sarveshjoshi29/processor_hardwarelab/nexys_a7.xdc

## ============================================================================
## Nexys A7-100T XDC Constraints for RV32IMA Dual-Core SoC
## ============================================================================
## Board: Digilent Nexys A7-100T (Artix-7 XC7A100T-1CSG324C)
## ============================================================================

## ---- Clock (100 MHz onboard oscillator) ----
set_property -dict { PACKAGE_PIN E3  IOSTANDARD LVCMOS33 } [get_ports {CLK100MHZ}]
create_clock -add -name sys_clk_pin -period 10.00 -waveform {0 5} [get_ports {CLK100MHZ}]

## ---- Reset (Center Button — BTNC) ----
set_property -dict { PACKAGE_PIN N17 IOSTANDARD LVCMOS33 } [get_ports {BTNC}]

## ---- Slide Switches (active-high) ----
set_property -dict { PACKAGE_PIN J15 IOSTANDARD LVCMOS33 } [get_ports {SW[0]}]
set_property -dict { PACKAGE_PIN L16 IOSTANDARD LVCMOS33 } [get_ports {SW[1]}]
set_property -dict { PACKAGE_PIN M13 IOSTANDARD LVCMOS33 } [get_ports {SW[2]}]
set_property -dict { PACKAGE_PIN R15 IOSTANDARD LVCMOS33 } [get_ports {SW[3]}]
set_property -dict { PACKAGE_PIN R17 IOSTANDARD LVCMOS33 } [get_ports {SW[4]}]
set_property -dict { PACKAGE_PIN T18 IOSTANDARD LVCMOS33 } [get_ports {SW[5]}]
set_property -dict { PACKAGE_PIN U18 IOSTANDARD LVCMOS33 } [get_ports {SW[6]}]
set_property -dict { PACKAGE_PIN R13 IOSTANDARD LVCMOS33 } [get_ports {SW[7]}]
set_property -dict { PACKAGE_PIN T8  IOSTANDARD LVCMOS33 } [get_ports {SW[8]}]
set_property -dict { PACKAGE_PIN U8  IOSTANDARD LVCMOS33 } [get_ports {SW[9]}]
set_property -dict { PACKAGE_PIN R16 IOSTANDARD LVCMOS33 } [get_ports {SW[10]}]
set_property -dict { PACKAGE_PIN T13 IOSTANDARD LVCMOS33 } [get_ports {SW[11]}]
set_property -dict { PACKAGE_PIN H6  IOSTANDARD LVCMOS33 } [get_ports {SW[12]}]
set_property -dict { PACKAGE_PIN U12 IOSTANDARD LVCMOS33 } [get_ports {SW[13]}]
set_property -dict { PACKAGE_PIN U11 IOSTANDARD LVCMOS33 } [get_ports {SW[14]}]
set_property -dict { PACKAGE_PIN V10 IOSTANDARD LVCMOS33 } [get_ports {SW[15]}]

## ---- LEDs ----
set_property -dict { PACKAGE_PIN H17 IOSTANDARD LVCMOS33 } [get_ports {LED[0]}]
set_property -dict { PACKAGE_PIN K15 IOSTANDARD LVCMOS33 } [get_ports {LED[1]}]
set_property -dict { PACKAGE_PIN J13 IOSTANDARD LVCMOS33 } [get_ports {LED[2]}]
set_property -dict { PACKAGE_PIN N14 IOSTANDARD LVCMOS33 } [get_ports {LED[3]}]
set_property -dict { PACKAGE_PIN R18 IOSTANDARD LVCMOS33 } [get_ports {LED[4]}]
set_property -dict { PACKAGE_PIN V17 IOSTANDARD LVCMOS33 } [get_ports {LED[5]}]
set_property -dict { PACKAGE_PIN U17 IOSTANDARD LVCMOS33 } [get_ports {LED[6]}]
set_property -dict { PACKAGE_PIN U16 IOSTANDARD LVCMOS33 } [get_ports {LED[7]}]
set_property -dict { PACKAGE_PIN V16 IOSTANDARD LVCMOS33 } [get_ports {LED[8]}]
set_property -dict { PACKAGE_PIN T15 IOSTANDARD LVCMOS33 } [get_ports {LED[9]}]
set_property -dict { PACKAGE_PIN U14 IOSTANDARD LVCMOS33 } [get_ports {LED[10]}]
set_property -dict { PACKAGE_PIN T16 IOSTANDARD LVCMOS33 } [get_ports {LED[11]}]
set_property -dict { PACKAGE_PIN V15 IOSTANDARD LVCMOS33 } [get_ports {LED[12]}]
set_property -dict { PACKAGE_PIN V14 IOSTANDARD LVCMOS33 } [get_ports {LED[13]}]
set_property -dict { PACKAGE_PIN V12 IOSTANDARD LVCMOS33 } [get_ports {LED[14]}]
set_property -dict { PACKAGE_PIN V11 IOSTANDARD LVCMOS33 } [get_ports {LED[15]}]

## ---- 7-Segment Display ----
set_property -dict { PACKAGE_PIN T10 IOSTANDARD LVCMOS33 } [get_ports {SEG[0]}]
set_property -dict { PACKAGE_PIN R10 IOSTANDARD LVCMOS33 } [get_ports {SEG[1]}]
set_property -dict { PACKAGE_PIN K16 IOSTANDARD LVCMOS33 } [get_ports {SEG[2]}]
set_property -dict { PACKAGE_PIN K13 IOSTANDARD LVCMOS33 } [get_ports {SEG[3]}]
set_property -dict { PACKAGE_PIN P15 IOSTANDARD LVCMOS33 } [get_ports {SEG[4]}]
set_property -dict { PACKAGE_PIN T11 IOSTANDARD LVCMOS33 } [get_ports {SEG[5]}]
set_property -dict { PACKAGE_PIN L18 IOSTANDARD LVCMOS33 } [get_ports {SEG[6]}]

set_property -dict { PACKAGE_PIN J17 IOSTANDARD LVCMOS33 } [get_ports {AN[0]}]
set_property -dict { PACKAGE_PIN J18 IOSTANDARD LVCMOS33 } [get_ports {AN[1]}]
set_property -dict { PACKAGE_PIN T9  IOSTANDARD LVCMOS33 } [get_ports {AN[2]}]
set_property -dict { PACKAGE_PIN J14 IOSTANDARD LVCMOS33 } [get_ports {AN[3]}]
set_property -dict { PACKAGE_PIN P14 IOSTANDARD LVCMOS33 } [get_ports {AN[4]}]
set_property -dict { PACKAGE_PIN T14 IOSTANDARD LVCMOS33 } [get_ports {AN[5]}]
set_property -dict { PACKAGE_PIN K2  IOSTANDARD LVCMOS33 } [get_ports {AN[6]}]
set_property -dict { PACKAGE_PIN U13 IOSTANDARD LVCMOS33 } [get_ports {AN[7]}]

## ---- Decimal Point ----
set_property -dict { PACKAGE_PIN H15 IOSTANDARD LVCMOS33 } [get_ports {DP}]

## ---- UART on Nexys A7 onboard USB-UART (COM port) ----
## FPGA TX -> PC RX (Digilent name: UART_RXD_OUT)
set_property -dict { PACKAGE_PIN D4 IOSTANDARD LVCMOS33 } [get_ports {JA1}]
## PC TX -> FPGA RX (Digilent name: UART_TXD_IN)
set_property -dict { PACKAGE_PIN C4 IOSTANDARD LVCMOS33 } [get_ports {JA2}]

## ---- Timing Constraints ----
## The generated divided clock is not a true clock for Vivado;
## tell it to treat it as a generated clock for timing analysis.
## In full-speed mode (SW[15:14]=11), sys_clk = CLK100MHZ (no divider).
set_false_path -from [get_ports {BTNC}]
set_false_path -from [get_ports {SW[*]}]

## Constrain the divider output as a generated clock
## (full-speed mode: 50 MHz = divide-by-2; slower modes divide further)
create_generated_clock -name div_clk -source [get_ports CLK100MHZ] \
    -divide_by 2 [get_pins {div_clk_reg/Q}]

## Multi-cycle path for slow clock domains (debug modes)
## These are conservative — Vivado will over-constrain but still close timing.

## ---- Bitstream Configuration ----
set_property CFGBVS VCCO [current_design]
set_property CONFIG_VOLTAGE 3.3 [current_design]
set_property BITSTREAM.GENERAL.COMPRESS TRUE [current_design]
set_property BITSTREAM.CONFIG.CONFIGRATE 33 [current_design]
set_property CONFIG_MODE SPIx4 [current_design]
