sarveshjoshi29/processor_hardwarelab/modules/IF_ID.v

`timescale 1ns/1ps
// ============================================================================
// IF/ID Stage — Instruction Fetch & Decode
// ============================================================================
// Changes from Phase 1:
//   - Removed WB-stage forwarding signals (forwarding now handled centrally)
//   - Added flush input for branch mispredicts
//   - Pipeline register (id_ex_reg) now has flush support
//   - Added AUIPC immediate generation and signal passthrough
//   - Added RV32M (muldiv) decode
//   - Added branch prediction passthrough (predicted_taken, predicted_target)
// ============================================================================
module IF_ID
#(
    parameter [31:0] RESET = 32'h0000_0000
)
(
    input clk,
    input reset,         // active-low (negated externally)
    input stall,
    output reg exception,

    // Instruction memory interface
    input inst_mem_is_valid,
    input  [31:0] inst_mem_read_data,

    // Pipeline control
    input  stall_read_i,
    input  [31:0] inst_fetch_pc,
    input  [31:0] instruction_i,

    // Hazard control
    input  stall_if_id,      // 1 = hold IF/ID register (load-use stall)
    input  stall_div,        // 1 = divider busy, hold ID/EX register
    input  flush_if_id,      // 1 = insert NOP (branch flush)

    input  [1:0]  inst_mem_offset,

    // Outputs to ID/EX register
    output [31:0] execute_immediate_w,
    output        immediate_sel_w,
    output        alu_w,
    output        lui_w,
    output        auipc_w,
    output        jal_w,
    output        jalr_w,
    output        branch_w,
    output        mem_write_w,
    output        mem_to_reg_w,
    output        arithsubtype_w,
    output        muldiv_w,
    output [31:0] pc_w,
    output [4:0]  src1_select_w,
    output [4:0]  src2_select_w,
    output [4:0]  dest_reg_sel_w,
    output [2:0]  alu_operation_w,
    output        illegal_inst_w,
    output [31:0] instruction_o,

    // Branch prediction passthrough
    input         predicted_taken_i,
    input  [31:0] predicted_target_i,
    output        predicted_taken_w,
    output [31:0] predicted_target_w,

    // RV32A atomic passthrough
    output        atomic_lr_w,
    output        atomic_sc_w,

    // CSR passthrough (Phase 5)
    output        csr_en_w
);

`include "opcode.vh"

// ---- Local signals ----
reg  [31:0] immediate;
reg         illegal_inst;

// ============================================================================
// IF: Instruction selection
// ============================================================================
assign instruction_o = (inst_mem_read_data == 32'b0) ? NOP
                     : (stall_read_i)                ? NOP
                     : inst_mem_read_data;

// ============================================================================
// Exception detection
// ============================================================================
always @(posedge clk or negedge reset) begin
    if (!reset)
        exception <= 1'b0;
    else if (illegal_inst || inst_mem_offset != 2'b00)
        exception <= 1'b1;
    else
        exception <= exception;  // explicit hold — avoid latch inference
end

// ============================================================================
// ID: Immediate generation (combinational)
// ============================================================================
always @(*) begin
    immediate    = 32'h0;
    illegal_inst = 1'b0;

    case (instruction_i[`OPCODE])
        JALR  : immediate = {{20{instruction_i[31]}}, instruction_i[31:20]};
        BRANCH: immediate = {{20{instruction_i[31]}}, instruction_i[7],
                              instruction_i[30:25], instruction_i[11:8], 1'b0};
        LOAD  : immediate = {{20{instruction_i[31]}}, instruction_i[31:20]};
        STORE : immediate = {{20{instruction_i[31]}}, instruction_i[31:25],
                              instruction_i[11:7]};
        ARITHI: immediate = (instruction_i[`FUNC3] == SLL ||
                              instruction_i[`FUNC3] == SR)
                           ? {27'b0, instruction_i[24:20]}
                           : {{20{instruction_i[31]}}, instruction_i[31:20]};
        ARITHR: immediate = 32'h0;
        LUI   : immediate = {instruction_i[31:12], 12'b0};
        AUIPC : immediate = {instruction_i[31:12], 12'b0};
        JAL   : immediate = {{12{instruction_i[31]}}, instruction_i[19:12],
                              instruction_i[20], instruction_i[30:21], 1'b0};
        AMO   : immediate = 32'h0;  // lr.w/sc.w: address = rs1, no immediate
        SYSTEM: immediate = {{20{instruction_i[31]}}, instruction_i[31:20]}; // CSR addr in [11:0]
        default: illegal_inst = 1'b1;
    endcase
end

// ============================================================================
// ID → EX Pipeline Register
// ============================================================================
id_ex_reg u_id_ex (
    .clk             (clk),
    .reset_n         (reset),
    .stall_n         (stall_read_i),
    .stall_hazard    (stall_if_id),    // load-use stall
    .stall_div       (stall_div),      // divider busy — hold
    .flush           (flush_if_id),    // branch flush

    // From ID
    .immediate_i     (immediate),
    .immediate_sel_i (
        (instruction_i[`OPCODE] == JALR)  ||
        (instruction_i[`OPCODE] == LOAD)  ||
        (instruction_i[`OPCODE] == ARITHI)
    ),
    .alu_i           (instruction_i[`OPCODE] == ARITHI || instruction_i[`OPCODE] == ARITHR),
    .lui_i           (instruction_i[`OPCODE] == LUI),
    .auipc_i         (instruction_i[`OPCODE] == AUIPC),
    .jal_i           (instruction_i[`OPCODE] == JAL),
    .jalr_i          (instruction_i[`OPCODE] == JALR),
    .branch_i        (instruction_i[`OPCODE] == BRANCH),
    .mem_write_i     (instruction_i[`OPCODE] == STORE),
    .mem_to_reg_i    (instruction_i[`OPCODE] == LOAD ||
                      (instruction_i[`OPCODE] == AMO && instruction_i[31:27] == FUNCT5_LR)),
    .arithsubtype_i  (
        instruction_i[`SUBTYPE] &&
        !(instruction_i[`OPCODE] == ARITHI &&
          instruction_i[`FUNC3] == ADD)
    ),
    .muldiv_i        (
        instruction_i[`OPCODE] == ARITHR &&
        instruction_i[31:25] == FUNCT7_MULDIV
    ),
    .pc_i            (inst_fetch_pc),
    .src1_sel_i      (instruction_i[`RS1]),
    .src2_sel_i      (instruction_i[`RS2]),
    .dest_reg_sel_i  (instruction_i[`RD]),
    .alu_op_i        (instruction_i[`FUNC3]),
    .illegal_inst_i  (illegal_inst),

    // Branch prediction passthrough
    .predicted_taken_i  (predicted_taken_i),
    .predicted_target_i (predicted_target_i),

    // RV32A atomic signals
    .atomic_lr_i         (instruction_i[`OPCODE] == AMO && instruction_i[31:27] == FUNCT5_LR),
    .atomic_sc_i         (instruction_i[`OPCODE] == AMO && instruction_i[31:27] == FUNCT5_SC),

    // CSR signals (Phase 5)
    .csr_en_i            (instruction_i[`OPCODE] == SYSTEM && instruction_i[`FUNC3] != 3'b000),

    // To EX (wires)
    .execute_immediate_o (execute_immediate_w),
    .immediate_sel_o     (immediate_sel_w),
    .alu_o               (alu_w),
    .lui_o               (lui_w),
    .auipc_o             (auipc_w),
    .jal_o               (jal_w),
    .jalr_o              (jalr_w),
    .branch_o            (branch_w),
    .mem_write_o         (mem_write_w),
    .mem_to_reg_o        (mem_to_reg_w),
    .arithsubtype_o      (arithsubtype_w),
    .muldiv_o            (muldiv_w),
    .pc_o                (pc_w),
    .src1_sel_o          (src1_select_w),
    .src2_sel_o          (src2_select_w),
    .dest_reg_sel_o      (dest_reg_sel_w),
    .alu_op_o            (alu_operation_w),
    .illegal_inst_o      (illegal_inst_w),

    // Branch prediction passthrough
    .predicted_taken_o   (predicted_taken_w),
    .predicted_target_o  (predicted_target_w),

    // RV32A atomic outputs
    .atomic_lr_o         (atomic_lr_w),
    .atomic_sc_o         (atomic_sc_w),

    // CSR output (Phase 5)
    .csr_en_o            (csr_en_w)
);
endmodule


// ============================================================================
// ID → EX Pipeline Register Module
// ============================================================================
// On flush or load-use stall, all control signals go to 0 (NOP bubble).
// On div stall, holds all values.
// ============================================================================
module id_ex_reg (
    input         clk,
    input         reset_n,        // active-low reset
    input         stall_n,        // system-level stall (active-low enable)
    input         stall_hazard,   // 1 = load-use hazard, insert bubble
    input         stall_div,      // 1 = divider busy, hold current values
    input         flush,          // 1 = branch mispredict, insert bubble

    // Inputs from ID
    input  [31:0] immediate_i,
    input         immediate_sel_i,
    input         alu_i,
    input         lui_i,
    input         auipc_i,
    input         jal_i,
    input         jalr_i,
    input         branch_i,
    input         mem_write_i,
    input         mem_to_reg_i,
    input         arithsubtype_i,
    input         muldiv_i,
    input  [31:0] pc_i,
    input  [4:0]  src1_sel_i,
    input  [4:0]  src2_sel_i,
    input  [4:0]  dest_reg_sel_i,
    input  [2:0]  alu_op_i,
    input         illegal_inst_i,

    // Branch prediction passthrough
    input         predicted_taken_i,
    input  [31:0] predicted_target_i,

    // RV32A atomic signals
    input         atomic_lr_i,
    input         atomic_sc_i,

    // CSR signals (Phase 5)
    input         csr_en_i,

    // Outputs to EX
    output reg [31:0] execute_immediate_o,
    output reg        immediate_sel_o,
    output reg        alu_o,
    output reg        lui_o,
    output reg        auipc_o,
    output reg        jal_o,
    output reg        jalr_o,
    output reg        branch_o,
    output reg        mem_write_o,
    output reg        mem_to_reg_o,
    output reg        arithsubtype_o,
    output reg        muldiv_o,
    output reg [31:0] pc_o,
    output reg [4:0]  src1_sel_o,
    output reg [4:0]  src2_sel_o,
    output reg [4:0]  dest_reg_sel_o,
    output reg [2:0]  alu_op_o,
    output reg        illegal_inst_o,

    // Branch prediction passthrough
    output reg        predicted_taken_o,
    output reg [31:0] predicted_target_o,

    // RV32A atomic outputs
    output reg        atomic_lr_o,
    output reg        atomic_sc_o,

    // CSR output (Phase 5)
    output reg        csr_en_o
);

always @(posedge clk or negedge reset_n) begin
    if (!reset_n || flush) begin
        // ---- Reset or branch flush: insert NOP bubble ----
        execute_immediate_o <= 32'h0;
        immediate_sel_o     <= 1'b0;
        alu_o               <= 1'b0;
        lui_o               <= 1'b0;
        auipc_o             <= 1'b0;
        jal_o               <= 1'b0;
        jalr_o              <= 1'b0;
        branch_o            <= 1'b0;
        mem_write_o         <= 1'b0;
        mem_to_reg_o        <= 1'b0;
        arithsubtype_o      <= 1'b0;
        muldiv_o            <= 1'b0;
        pc_o                <= 32'h0;
        src1_sel_o          <= 5'h0;
        src2_sel_o          <= 5'h0;
        dest_reg_sel_o      <= 5'h0;
        alu_op_o            <= 3'h0;
        illegal_inst_o      <= 1'b0;
        predicted_taken_o   <= 1'b0;
        predicted_target_o  <= 32'h0;
        atomic_lr_o         <= 1'b0;
        atomic_sc_o         <= 1'b0;
        csr_en_o            <= 1'b0;
    end
    else if (stall_div) begin
        // ---- Divider busy: hold all values (do nothing) ----
    end
    else if (stall_hazard) begin
        // ---- Load-use hazard: insert NOP bubble ----
        execute_immediate_o <= 32'h0;
        immediate_sel_o     <= 1'b0;
        alu_o               <= 1'b0;
        lui_o               <= 1'b0;
        auipc_o             <= 1'b0;
        jal_o               <= 1'b0;
        jalr_o              <= 1'b0;
        branch_o            <= 1'b0;
        mem_write_o         <= 1'b0;
        mem_to_reg_o        <= 1'b0;
        arithsubtype_o      <= 1'b0;
        muldiv_o            <= 1'b0;
        pc_o                <= 32'h0;
        src1_sel_o          <= 5'h0;
        src2_sel_o          <= 5'h0;
        dest_reg_sel_o      <= 5'h0;
        alu_op_o            <= 3'h0;
        illegal_inst_o      <= 1'b0;
        predicted_taken_o   <= 1'b0;
        predicted_target_o  <= 32'h0;
        atomic_lr_o         <= 1'b0;
        atomic_sc_o         <= 1'b0;
        csr_en_o            <= 1'b0;
    end
    else if (!stall_n) begin
        execute_immediate_o <= immediate_i;
        immediate_sel_o     <= immediate_sel_i;
        alu_o               <= alu_i;
        lui_o               <= lui_i;
        auipc_o             <= auipc_i;
        jal_o               <= jal_i;
        jalr_o              <= jalr_i;
        branch_o            <= branch_i;
        mem_write_o         <= mem_write_i;
        mem_to_reg_o        <= mem_to_reg_i;
        arithsubtype_o      <= arithsubtype_i;
        muldiv_o            <= muldiv_i;
        pc_o                <= pc_i;
        src1_sel_o          <= src1_sel_i;
        src2_sel_o          <= src2_sel_i;
        dest_reg_sel_o      <= dest_reg_sel_i;
        alu_op_o            <= alu_op_i;
        illegal_inst_o      <= illegal_inst_i;
        predicted_taken_o   <= predicted_taken_i;
        predicted_target_o  <= predicted_target_i;
        atomic_lr_o         <= atomic_lr_i;
        atomic_sc_o         <= atomic_sc_i;
        csr_en_o            <= csr_en_i;
    end
end
endmodule
