sarveshjoshi29/processor_hardwarelab/(commit log)

2026-03-29 3 stage pipeline
2026-04-12 testbench: add RV32M edge-case and generated asm artifacts
2026-04-12 testbench: add dual-core and dual-program hex generation flow
2026-04-12 Added support for RV32A (atomic) instructions in pipeline stages
2026-04-19 added top and uart-tx of minidemo
2026-04-19 Add SoC UART dual core focused tests
2026-04-23 modified uart_rx file
2026-04-23 memgen: add dual-core uart demo hex generator
2026-04-23 added printing of data in csr
