sarveshjoshi29/processor_hardwarelab/(notices)

Notices in the files:
README.md:
License: MIT
